iustitiae233/esp32-s3-solder-inspector/archive/auto-generated-schematic/carrier-18pin/README.md

# 载板自动生成草稿（历史参考）

> 本目录不是最终嘉立创 EDA 工程，不用于生成 PCB 或下单。
> 当前有效方案见 `../../../2026-09-06-solder-ai-carrier-pcb.md`。

## 文件

- `carrier-easyeda.json`：按 EasyEDA 标准版公开格式生成的可编辑原理图源文件。
- `carrier-review.pdf`：同源生成的原理图预览，不是 EDA 导出验证结果。
- `connections.csv`：逐脚网络表。
- `../build_carrier.py`：生成脚本。

在嘉立创 EDA **标准版**中通过打开本地 EasyEDA 文件的入口加载 JSON。
目前尚未在实际编辑器中验证导入、运行 ERC 或分配 PCB 封装。
不能将此版本直接转 PCB 下单；接口符号具有电气引脚，但封装为空。

## 18 针为什么够用

依据本地 ATK-MC2640 用户手册 V1.1 和 ATK-OV2640 V2.2 原理图：
相机使用 D0-D7、PCLK、HREF、VSYNC、SDA、SCL，共 13 个 GPIO。
模块自带 24MHz 有源晶振，不接主控 XCLK，GPIO15 留空。
RST 经 10k 上拉到 3V3；PWDN 接地；FLASH 经 10k 下拉到地。
屏幕和触摸合计 9 个 GPIO，按键 1 个，总计 23 个。
GPIO48 现在不接外部灯环，保留为 NC；核心板上的板载 RGB 仍由核心板自身电路决定。
核心板第三脚丝印为 `RST`，原理图和测试点均使用 `RST`，不使用 `EN` 命名。

J3 的针号来自原厂 P1，不是根据名称随意排列：

| 奇数针 | 信号 | 偶数针 | 信号 |
|---|---|---|---|
| 1 | GND | 2 | 3V3 |
| 3 | SCL | 4 | VSYNC |
| 5 | SDA | 6 | HREF |
| 7 | D0 | 8 | RST |
| 9 | D2 | 10 | D1 |
| 11 | D4 | 12 | D3 |
| 13 | D6 | 14 | D5 |
| 15 | PCLK | 16 | D7 |
| 17 | PWDN | 18 | FLASH |

## 相对于原设计的更正

- J1 原理图拆成 44 个 `1x1P` 排母符号：左列为 `J1L01` 至 `J1L22`，
  右列为 `J1R01` 至 `J1R22`，各自从天线端往 USB 端编号。
  PCB 中每个封装必须锁定在 2.54mm 网格；两列中心距按核心板实物测量，
  不是普通双排排母的 2.54mm 间距。
- 实体物料仍建议购买两条 `2.54mm 1x40P 可裁剪单排排母`，各裁为 22P。
  不建议购买 44 个独立排母实体，无法保证插板平整和机械强度。
- J3 改为 2x9；不引出 XCLK。
- 删除外部灯环：不再放置 J4、D1、LED_DIN，也不使用 GPIO48。
- 屏模块已有 S8050 背光驱动，不添加原文中备用的载板低边开关。
- 屏用 3.3V 供电时，原厂图要求短接屏模块自身的 J1 稳压器旁路跳线。
  此 J1 不是载板核心板插座。
- 添加 SCCB 的 4.7k 上拉电阻；模块手册明确允许与 3.3V MCU 直接连接。
- 相机 FLASH 下拉不等于任何跳线状态都能关闭闪光灯。
  核对模块 R2/R3 选择，固件关闭传感器 STROBE；勿同时装通两个选择电阻。

## 上电与出板前必须核查

1. 按实物确认核心板版本、插座间距、针一方向和相机线缆是否镜像。
2. 外部照明改为独立的 USB/DC/插座光源，禁止将 220V 市电引入载板。
3. YD 核心板的 5Vin 引出与 USB 供电存在跳线/二极管路径，确认 IN-OUT 配置与电流能力；
   不要仅凭网络名认定 USB 接入后载板一定有 5V。
4. 核对核心板 LDO 对屏幕、相机与 ESP32 峰值电流的承载及温升。
5. 固件要适配相机自带 24MHz 时钟，不得继续在 GPIO15 输出并外接到模块晶振输出。
   具体摄像头驱动是否支持无外部 XCLK 的初始化路径尚未验证。
6. 分配全部直插封装；6x6 四脚按键需按实际内部共接关系选符号与封装。
7. EDA 导入后导出网表，与 connections.csv 逐脚核对，运行 ERC，再进行 PCB 布局和 DRC。

## 去耦电容的实际位置

- `C2`：紧贴 J2 显示屏接口的 `3V3` 和 `GND` 引脚。
- `C3`：紧贴 J3 相机接口的 `3V3` 和 `GND` 引脚。
- `C4`：紧贴 J1 核心板插座附近的 `3V3` 和 `GND` 引脚，作为载板 3V3 入口去耦。
- `C5`：靠近 `R4/R5` 相机 SCCB 上拉电阻和 J3，接 `3V3` 与 `GND`。

`C1` 不是电源去耦，而是 GPIO14 按键的硬件消抖电容，应靠近 `K1` 和 `J1L20`（GPIO14）放置。
去耦电容应先走短线连接到电源和地，再接接口信号；不要把电容放在接口远处仅通过长线连接。
