iustitiae233/esp32-s3-solder-inspector/docs/reference-renders/camera-dim2.png

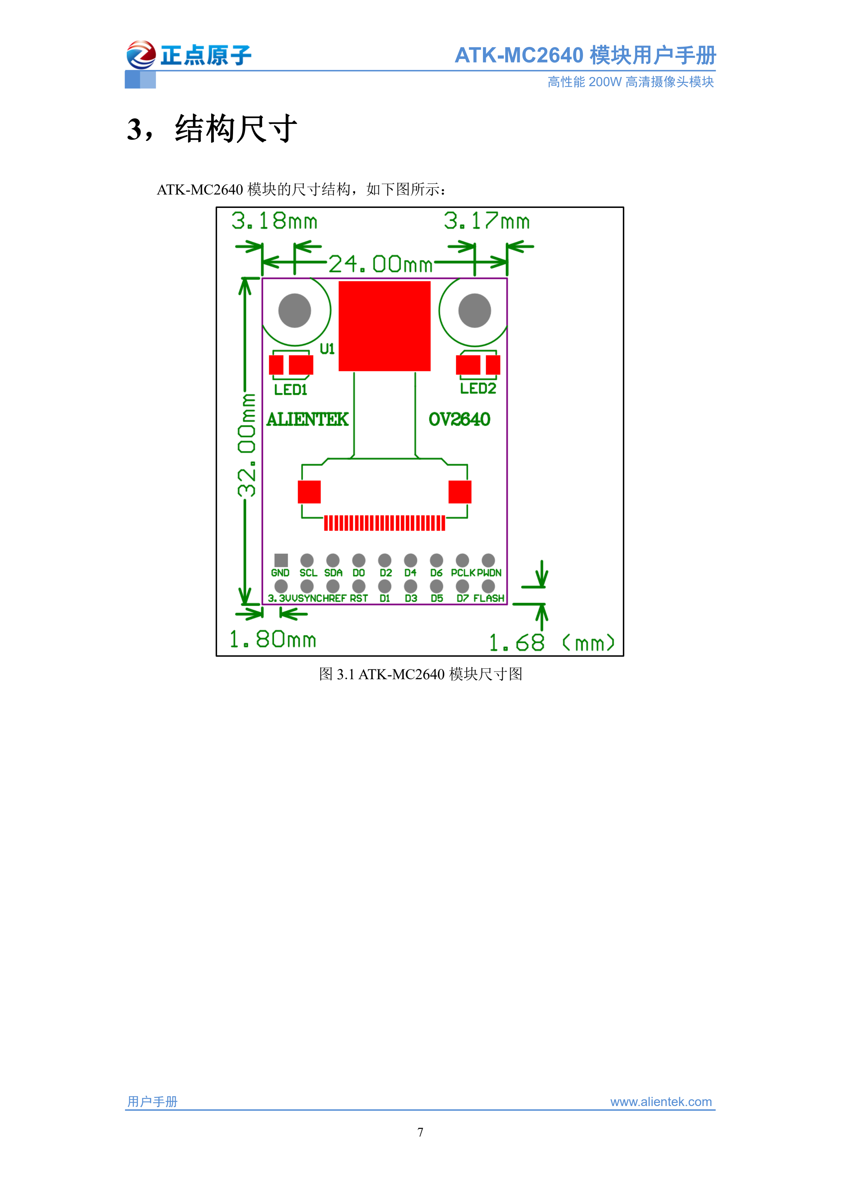
docs/reference-renders/camera-dim2.png
