iustitiae233/esp32-s3-solder-inspector/docs/reference-renders/camera-source.png

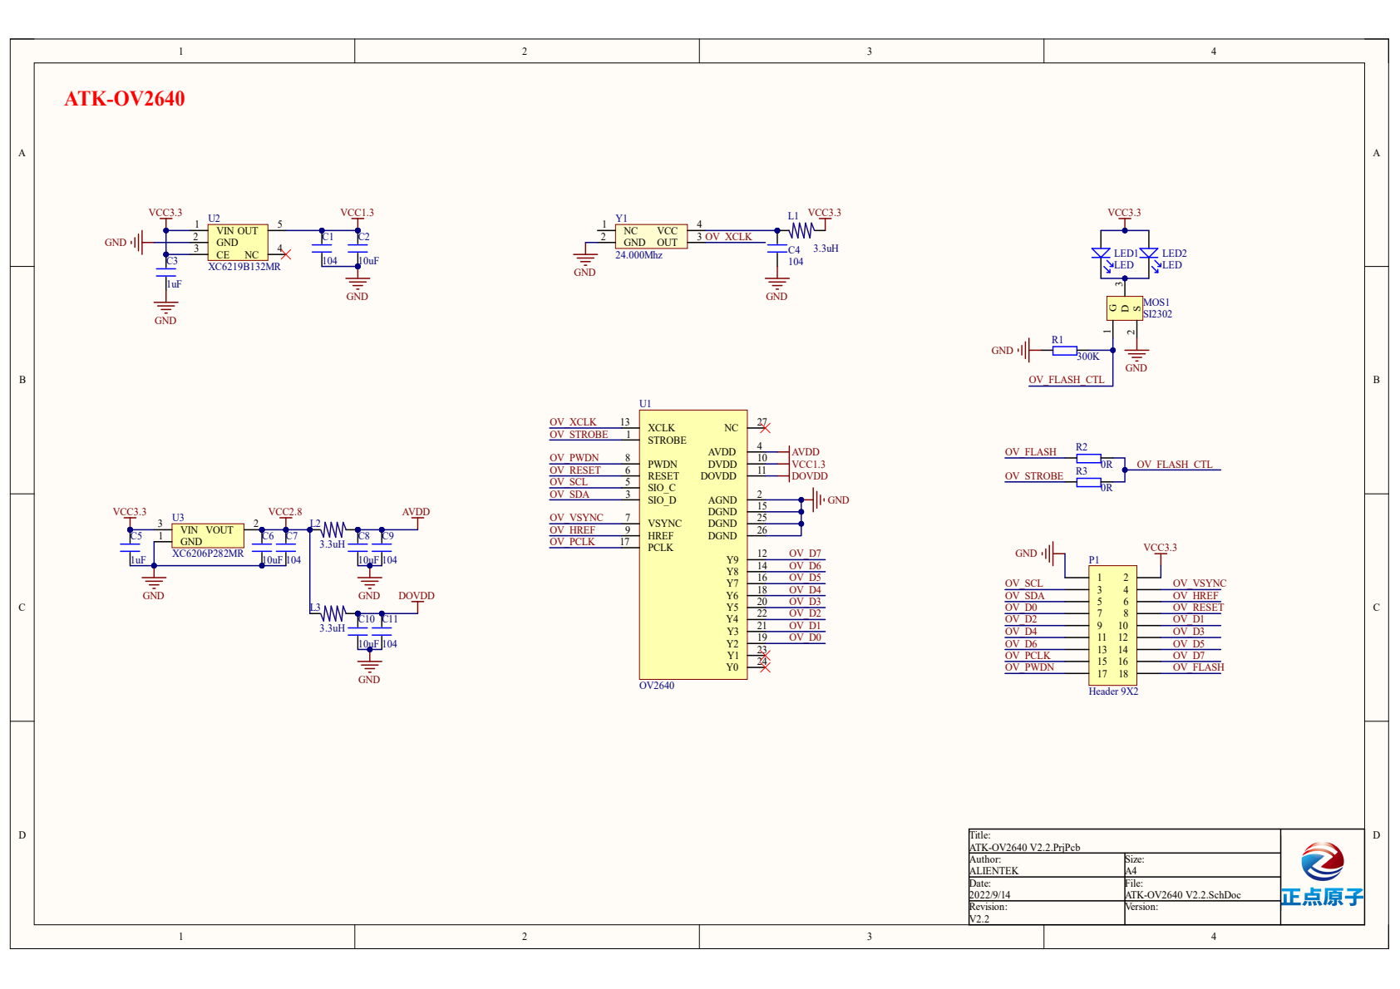
docs/reference-renders/camera-source.png
