iustitiae233/esp32-s3-solder-inspector/docs/reference-renders/core-metric.png

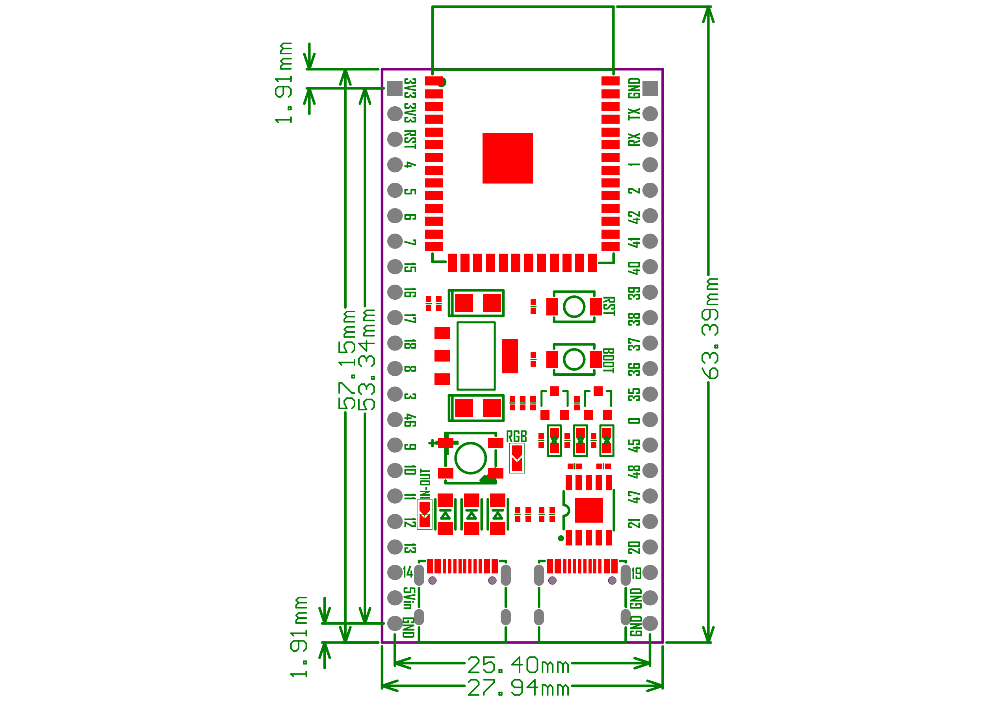
docs/reference-renders/core-metric.png
