iustitiae233/esp32-s3-solder-inspector/docs/reference-renders/pm254-datasheet.png

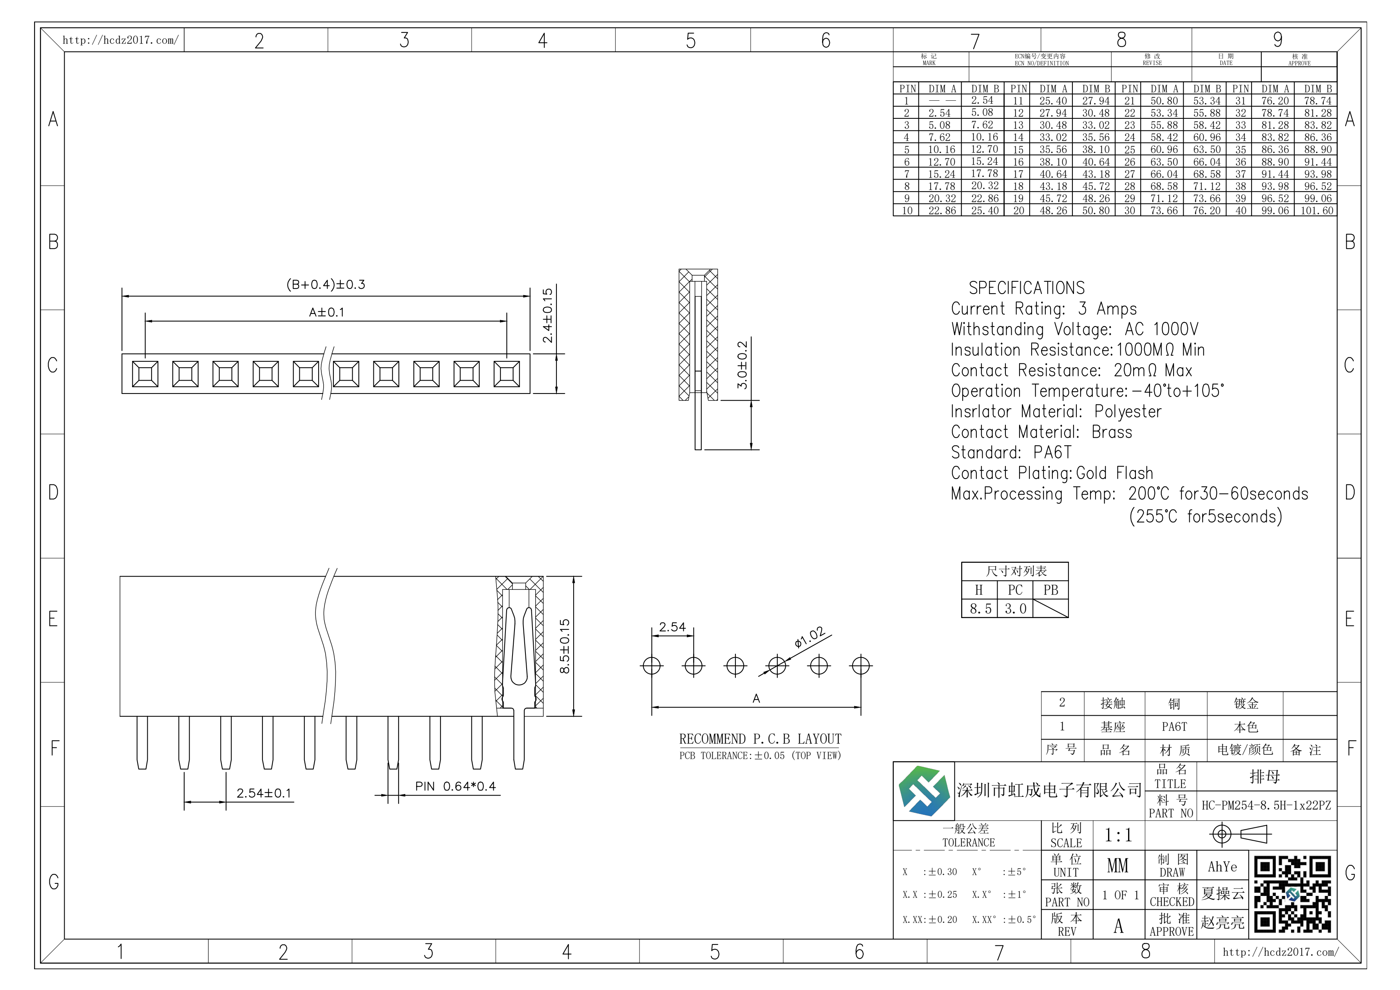
docs/reference-renders/pm254-datasheet.png
