iustitiae233/esp32-s3-solder-inspector/docs/reference-renders/screen-size-1.png

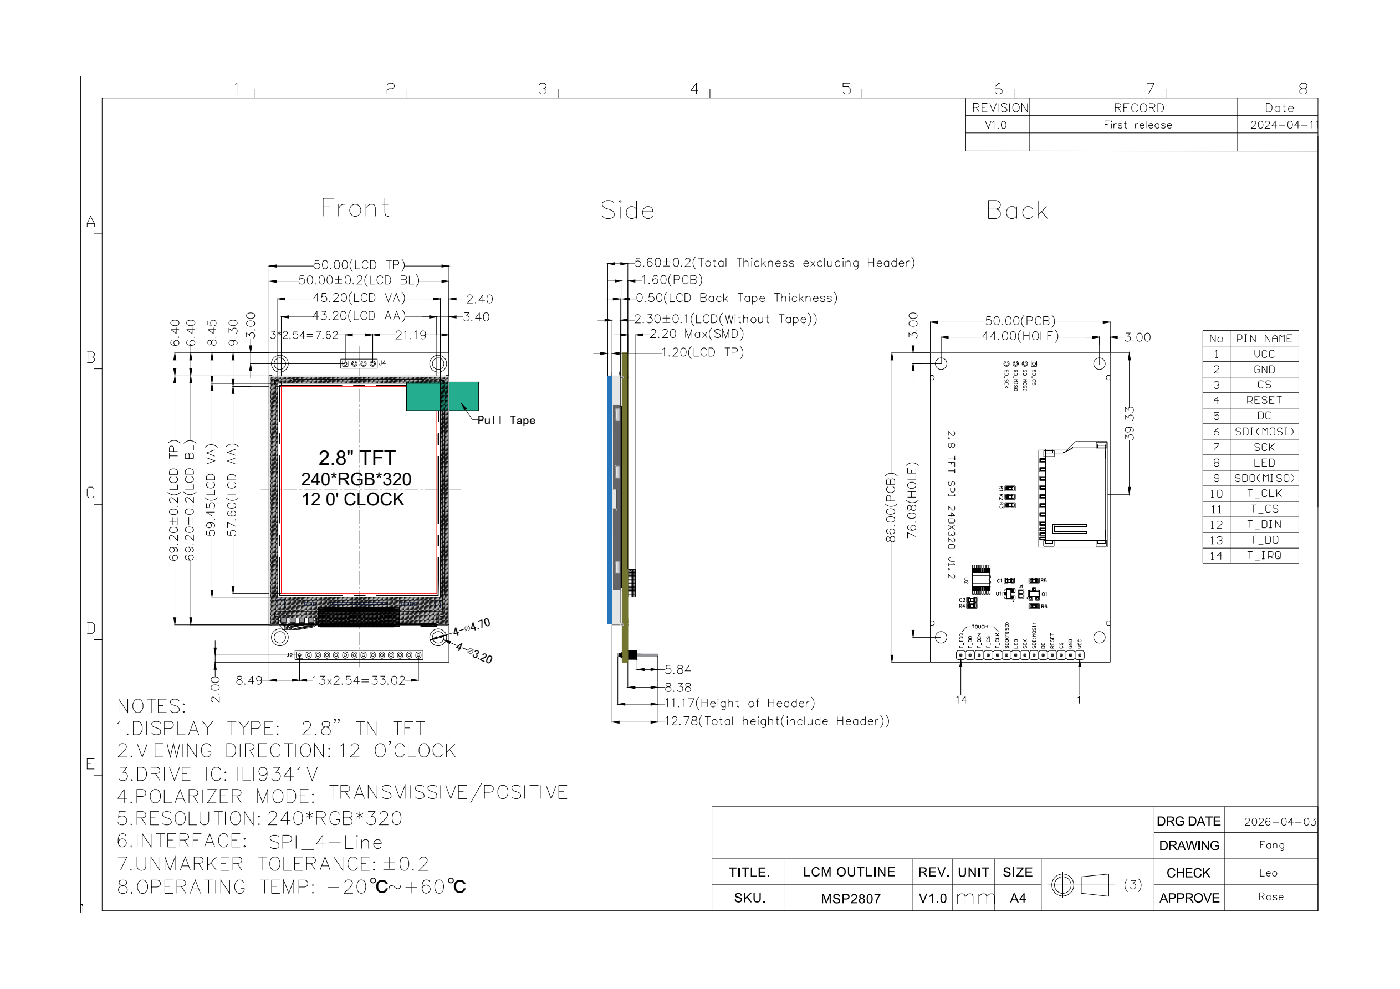
docs/reference-renders/screen-size-1.png
