iustitiae233/esp32-s3-solder-inspector/引脚图（已完善）.PNG

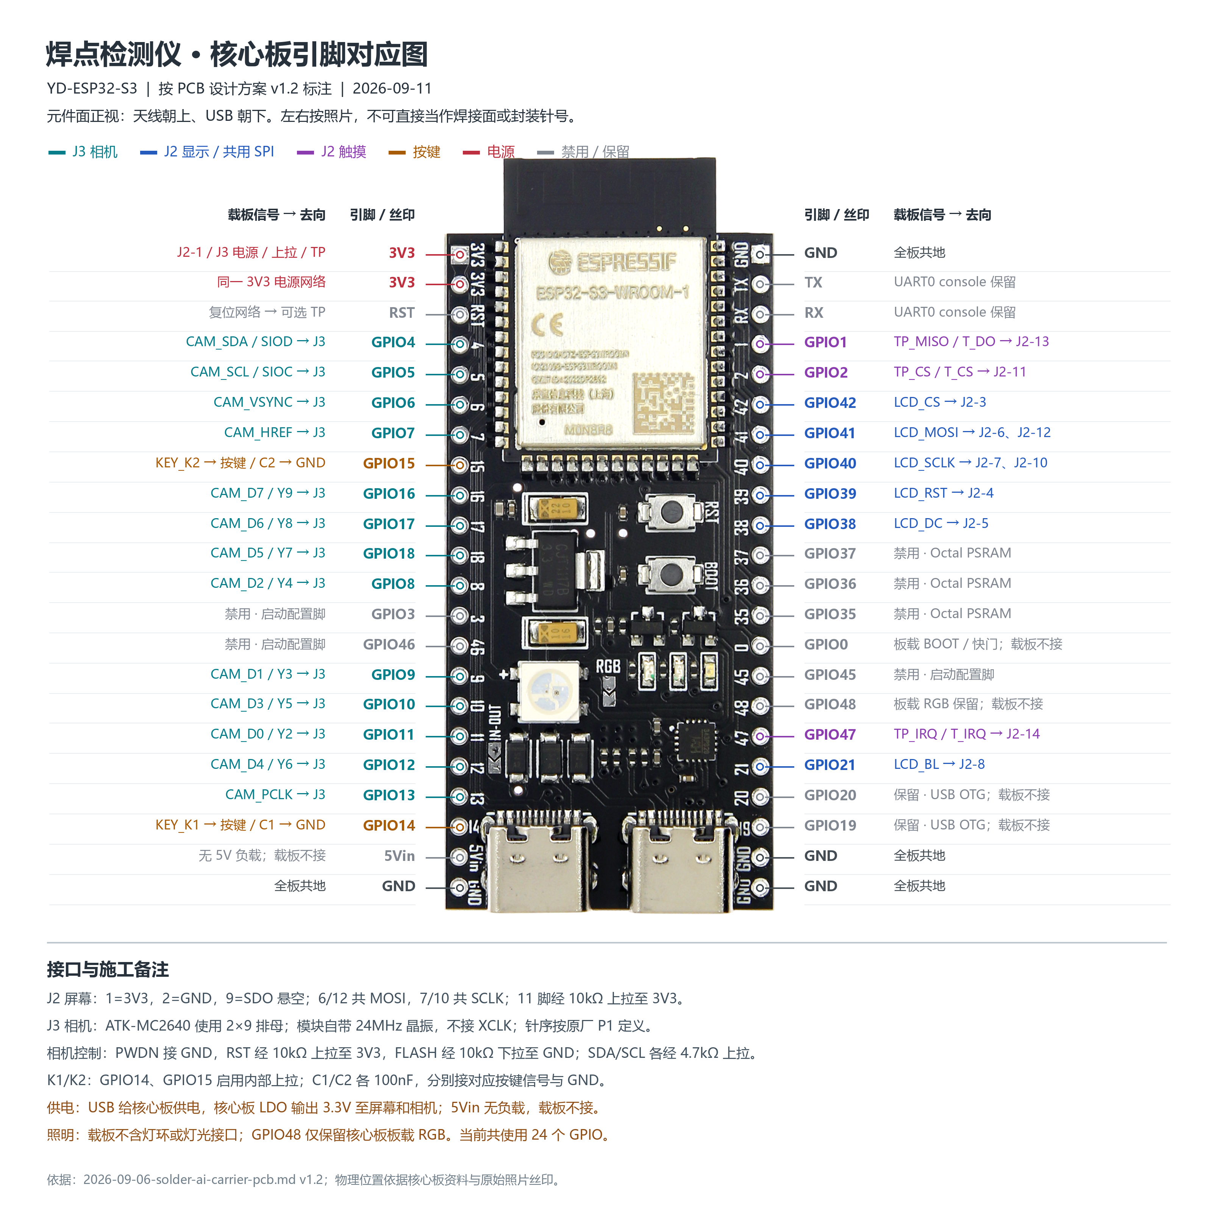
引脚图（已完善）.PNG
