iustitiae233/esp32-s3-solder-inspector/2026-09-06-solder-ai-carrier-pcb.md

# 焊点检测仪载板设计文档

> 状态：原理图及 PCB 已完成，本文按当前设计整理。
> 工具：嘉立创 EDA 标准版。
> 版本：v1.2（2026-09-11）。

---

## 1. 方案概述

本项目使用 YD-ESP32-S3-N16R8 开发板作为可插拔核心板，载板负责连接：

- MSP2807 2.8 英寸 ILI9341 SPI 电阻触摸屏；
- ATK-MC2640（OV2640 V2.2）18 针摄像头模块；
- 两个直插轻触按键；
- 必要的上拉、下拉和去耦器件。

外部照明使用独立 USB、直流或插座光源，不接入载板。载板不包含灯环接口、WS2812、
1N4007 或光源供电电路，也不将 220V 市电引入 PCB。

## 2. 硬件边界

| 项目 | 当前方案 |
|---|---|
| 核心板 | YD-ESP32-S3-N16R8 开发板整板插装 |
| 核心板接口 | 两条 1x22P、2.54mm 直插排母 |
| 屏幕 | MSP2807，ILI9341，240x320，SPI，XPT2046 电阻触摸 |
| 摄像头 | ATK-MC2640 / ATK-OV2640 V2.2，2x9P、2.54mm，共 18 针 |
| 操作输入 | 触摸屏 + K1/K2 两个按键 |
| 照明 | 独立外部光源，与载板电气隔离 |
| 供电 | USB 给核心板供电；核心板板载 LDO 向载板输出 3.3V |
| PCB | 双层板，通孔器件为主，底层优先保持连续 GND 铺铜 |

载板不重复设计 USB、3.3V LDO、BOOT 或复位外围。核心板丝印 `RST` 对应芯片使能/复位
网络，本文统一命名为 `RST`，不再使用 `EN`。

## 3. 核心板器件与机械接口

原理图使用嘉立创 EDA 中与实物匹配的 YD-ESP32-S3-N16R8 44 引脚开发板器件，
不再把左右两排画成两个独立连接器。PCB 封装必须满足：

- 左右各 22 个通孔；
- 同排孔距 2.54mm；
- 两排孔中心距 25.40mm；
- 每排首尾孔中心距 53.34mm；
- 开发板外形约 63.39mm x 27.94mm；
- USB、天线端和 1 脚方向与实物一致；
- 原理图引脚编号与 PCB 焊盘编号一一对应。

实际装配使用两条 `HC-PM254-8.5H-1x22PZ` 排母。其主要参数为 1x22P、2.54mm 间距、
胶体高度 8.5mm、推荐钻孔约 1.02mm。焊接时将开发板插入两条排母后再焊排母，作为定位治具。

### 3.1 GPIO 分配

| 功能 | GPIO | 功能 | GPIO |
|---|---:|---|---:|
| CAM_D0 | 11 | LCD_SCLK / T_CLK | 40 |
| CAM_D1 | 9 | LCD_MOSI / T_DIN | 41 |
| CAM_D2 | 8 | LCD_CS | 42 |
| CAM_D3 | 10 | LCD_DC | 38 |
| CAM_D4 | 12 | LCD_RST | 39 |
| CAM_D5 | 18 | LCD_BL | 21 |
| CAM_D6 | 17 | TP_MISO / T_DO | 1 |
| CAM_D7 | 16 | TP_CS / T_CS | 2 |
| CAM_VSYNC | 6 | TP_IRQ / T_IRQ | 47 |
| CAM_HREF | 7 | KEY_K1 | 14 |
| CAM_PCLK | 13 | CAM_SDA | 4 |
| CAM_SCL | 5 | KEY_K2 | 15 |

共使用 24 个 GPIO。相机自带 24MHz 晶振，因此原 XCLK 使用的 `GPIO15` 改接第二个按键
K2；`GPIO48` 不再连接外部灯，但核心板自身的板载 RGB 可能仍占用它。

以下引脚不用于载板扩展：

- GPIO19、GPIO20：USB；
- GPIO35、GPIO36、GPIO37：N16R8 模组内部 Octal PSRAM；
- GPIO0、GPIO3、GPIO45、GPIO46：启动配置相关；
- TX、RX：UART0 下载和调试；
- GPIO48：保留给核心板板载 RGB；
- 其他未使用引脚在原理图中放置 NC 标识。

## 4. J2 显示屏接口

接口为 `HDR-F_2.54_1x14P` 直插排母。针脚定义：

| 针号 | 模块丝印 | 载板网络 | GPIO | 说明 |
|---:|---|---|---:|---|
| 1 | VCC | 3.3V | - | 由核心板 LDO 输出供电 |
| 2 | GND | GND | - |  |
| 3 | CS | LCD_CS | 42 |  |
| 4 | RESET | LCD_RST | 39 |  |
| 5 | DC | LCD_DC | 38 |  |
| 6 | SDI/MOSI | LCD_MOSI | 41 | 与 T_DIN 共网 |
| 7 | SCK | LCD_SCLK | 40 | 与 T_CLK 共网 |
| 8 | LED | LCD_BL | 21 | 模块板载 S8050 驱动背光 |
| 9 | SDO/MISO | NC | - | 当前只写屏幕，不读取屏幕数据 |
| 10 | T_CLK | LCD_SCLK | 40 | 触摸 SPI 时钟 |
| 11 | T_CS | TP_CS | 2 | R1 10k 上拉到 3.3V |
| 12 | T_DIN | LCD_MOSI | 41 | 触摸 SPI 输入 |
| 13 | T_DO | TP_MISO | 1 | 触摸 SPI 输出 |
| 14 | T_IRQ | TP_IRQ | 47 | 触摸中断 |

网络名必须统一使用 `LCD_SCLK`，不得写成 `LCD_SLCK`。屏幕模块使用 3.3V 供电时，
按 MSP2807 原理图确认模块自身的稳压旁路跳线状态。

## 5. J3 摄像头接口

ATK-MC2640 模块自带 24MHz 有源晶振和稳压电路，载板不提供 XCLK。接口为 2x9P、
2.54mm 排母，针号严格按原厂 P1 定义：

| 奇数针 | 信号 | 连接 | 偶数针 | 信号 | 连接 |
|---:|---|---|---:|---|---|
| 1 | GND | GND | 2 | 3.3V | 3.3V |
| 3 | SCL | GPIO5 | 4 | VSYNC | GPIO6 |
| 5 | SDA | GPIO4 | 6 | HREF | GPIO7 |
| 7 | D0 | GPIO11 | 8 | RST | R2 10k 上拉至 3.3V |
| 9 | D2 | GPIO8 | 10 | D1 | GPIO9 |
| 11 | D4 | GPIO12 | 12 | D3 | GPIO10 |
| 13 | D6 | GPIO17 | 14 | D5 | GPIO18 |
| 15 | PCLK | GPIO13 | 16 | D7 | GPIO16 |
| 17 | PWDN | GND | 18 | FLASH | R3 10k 下拉至 GND |

R4、R5 分别将 CAM_SDA、CAM_SCL 通过 4.7k 上拉到 3.3V。相机模块的 FLASH 还受模块
内部 R2/R3 选择电阻和传感器 STROBE 控制，使用时确认模块焊接状态并在固件中关闭闪光。

## 6. 按键

K1/SW1、K2/SW2 均为 6x6x5mm 直插常开轻触开关：

```text
GPIO14 / KEY_K1 ----+---- K1 ---- GND
                    |
                    +---- C1 100nF ---- GND

GPIO15 / KEY_K2 ----+---- K2 ---- GND
                    |
                    +---- C2 100nF ---- GND
```

GPIO14、GPIO15 均在固件中启用内部上拉，按下时读取低电平。C1、C2 分别为 K1、K2
提供硬件消抖，不属于电源去耦，应分别靠近对应按键和 GPIO 连接处放置。固件仍建议
保留 20-50ms 消抖，以提高长按和连按识别的稳定性。

## 7. 电源与去耦

USB 向开发板输入 5V，开发板板载 LDO 产生 3.3V，再通过开发板 3.3V 引脚向屏幕、相机和
上拉电阻供电。载板上的 `3.3V` 电源符号表示同一个网络，本身不会产生电压。

外接灯已删除，因此载板没有 5V 负载。核心板 `5Vin` 若未使用，应标为 NC；不要仅放置一个
孤立 `+5V` 电源符号。也不要同时从外部 5V 和核心板 USB 反向给同一网络供电。

当前电容配置：

| 位号 | 数值 | 用途 | PCB 放置位置 |
|---|---|---|---|
| C1 | 100nF | 按键硬件消抖 | 紧贴 K1 和 GPIO14 网络 |
| C2 | 100nF | 按键硬件消抖 | 紧贴 K2 和 GPIO15 网络 |
| C3 | 100nF | 核心板 3.3V 入口去耦 | 紧贴核心板 3.3V/GND 引脚 |
| C4 | 100nF | 显示屏接口去耦 | 紧贴 J2 的 VCC/GND 引脚 |
| C5 | 100nF | 摄像头接口去耦 | 紧贴 J3 的 3.3V/GND 引脚 |

C1、C2 接在对应按键信号与 GND 之间；它们不是 3.3V 去耦电容。C3-C5 才是电源去耦，
均并联在 `3.3V-GND` 之间，不能串联在供电路径上。上拉电阻本身不需要额外去耦。

## 8. 辅助器件

| 位号 | 参数 | 用途 |
|---|---|---|
| R1 | 10k，直插 | TP_CS 上拉至 3.3V |
| R2 | 10k，直插 | CAM_RST 上拉至 3.3V |
| R3 | 10k，直插 | CAM_FLASH 下拉至 GND |
| R4 | 4.7k，直插 | CAM_SDA 上拉至 3.3V |
| R5 | 4.7k，直插 | CAM_SCL 上拉至 3.3V |
| C1 | 100nF，直插 | 按键消抖 |
| C2 | 100nF，直插 | K2 按键消抖 |
| C3-C5 | 100nF，直插 | 3.3V 去耦 |

## 9. PCB 布局与走线

模块机械尺寸：

- YD-ESP32-S3 开发板约 63.39mm x 27.94mm；
- MSP2807 屏幕 PCB 为 50mm x 86mm；
- ATK-MC2640 摄像头模块为 24mm x 32mm；
- 最终板框、安装孔和器件坐标以已完成的嘉立创 EDA PCB 工程为准。

走线要求：

1. CAM_D0-D7、PCLK、HREF、VSYNC 优先短、直、少过孔，PCLK 尤其避免绕行；
2. 相机并行数据线不要求严格等长，但长度应大致接近并保持连续参考地；
3. LCD_SCLK、LCD_MOSI 和片选线尽量短；
4. 3.3V 主干建议至少 20mil；普通信号可用 8-10mil；
5. 底层优先铺连续 GND 铜，避免高速信号跨越地平面裂缝；
6. C3、C4、C5 必须在 PCB 实际布局中贴近各自接口电源脚，原理图上的距离没有意义；
7. 核心板 USB 口、BOOT/RST 按键和天线区域不得被屏幕、外壳或高器件遮挡；
8. 丝印标注连接器 1 脚、模块朝向和主要信号，防止相机或屏幕反插。

## 10. 最终 BOM

| 类别 | 型号/规格 | 数量 |
|---|---|---:|
| 核心板 | YD-ESP32-S3-N16R8 | 1 |
| 核心板排母 | HC-PM254-8.5H-1x22PZ，1x22P，2.54mm | 2 |
| 显示屏排母 J2 | HDR-F_2.54_1x14P | 1 |
| 摄像头排母 J3 | 2x9P，2.54mm，直插排母 | 1 |
| 按键 K1/K2（SW1/SW2） | 6x6x5mm，直插，常开 | 2 |
| R1-R3 | 10k，1/4W，直插 | 3 |
| R4-R5 | 4.7k，1/4W，直插 | 2 |
| C1-C5 | 100nF，直插瓷片/独石 | 5 |

不再采购 J4、1N4007、S8050、1k 背光电阻及 WS2812 灯环。

## 11. 制板前检查

- [ ] 原理图 ERC 无错误；未使用引脚已放 NC 标识；
- [ ] 原理图引脚编号与 PCB 封装焊盘编号完全对应；
- [ ] 3.3V 网络名全图一致，没有混用 `3V3`；
- [ ] LCD_SCLK 拼写全图一致；
- [ ] J2-9 SDO 为 NC；GPIO15 仅连接 K2；GPIO48 和禁用/保留 GPIO 未误接；
- [ ] J3 针号及 1 脚方向与 ATK-MC2640 实物一致；
- [ ] 核心板两排孔中心距 25.40mm，开发板方向正确；
- [ ] PCB DRC 无错误，板框闭合，安装孔和边缘间距符合工艺要求；
- [ ] 已检查屏幕、相机、核心板和外壳之间无机械干涉。

## 12. 焊接与验收

1. 先焊电阻、电容和按键；
2. 使用核心板定位两条 1x22 排母后焊接，避免排母倾斜；
3. 焊接 J2/J3 前确认 1 脚和模块朝向；
4. 不插模块时检查 3.3V 对 GND 无短路；
5. 插入核心板并用 USB 供电，测量载板 3.3V；
6. 断电后插屏幕与相机，再逐项测试显示、触摸、按键和摄像头；
7. 外部照明单独供电，调整角度和漫射，避免焊点高光过曝。

验收项目：

- [ ] 3.3V 电压正常且核心板 LDO 无异常发热；
- [ ] 屏幕显示正常，触摸点按与坐标方向正常；
- [ ] K1、K2 按键均可识别，长按和连按无明显误触发；
- [ ] 相机 SCCB 初始化成功，图像无花屏、错位或持续丢帧；
- [ ] 外部光源下焊点曝光稳定、无严重阴影和高光溢出。

## 13. 变更记录

| 日期 | 版本 | 变更 |
|---|---|---|
| 2026-09-06 | v0.1 | 初版：16 针相机、GPIO15 XCLK、GPIO48 灯环方案 |
| 2026-09-07 | v0.2 | 相机改为 ATK-MC2640 18 针，自带 24MHz 晶振；PWDN/RST/FLASH 固定电平 |
| 2026-09-09 | v0.3 | 删除外接灯环、J4、1N4007 和 GPIO48 外接功能；统一 RST 命名 |
| 2026-09-10 | v0.4 | 核心板改用完整 44 引脚器件；修正原理图引脚与封装焊盘编号 |
| 2026-09-11 | v1.0 | 根据已完成原理图和 PCB 整理为当前设计基线 |
| 2026-09-11 | v1.1 | GPIO15 增加第二个按键 K2；GPIO 使用数改为 24；K2 使用固件消抖 |
| 2026-09-11 | v1.2 | 补充 K2 的 C2 100nF 硬件消抖电容；BOM 恢复为 C1-C5 共 5 个 |
