iustitiae233/esp32-s3-solder-inspector/docs/reference-renders/camera-manual-p4.png

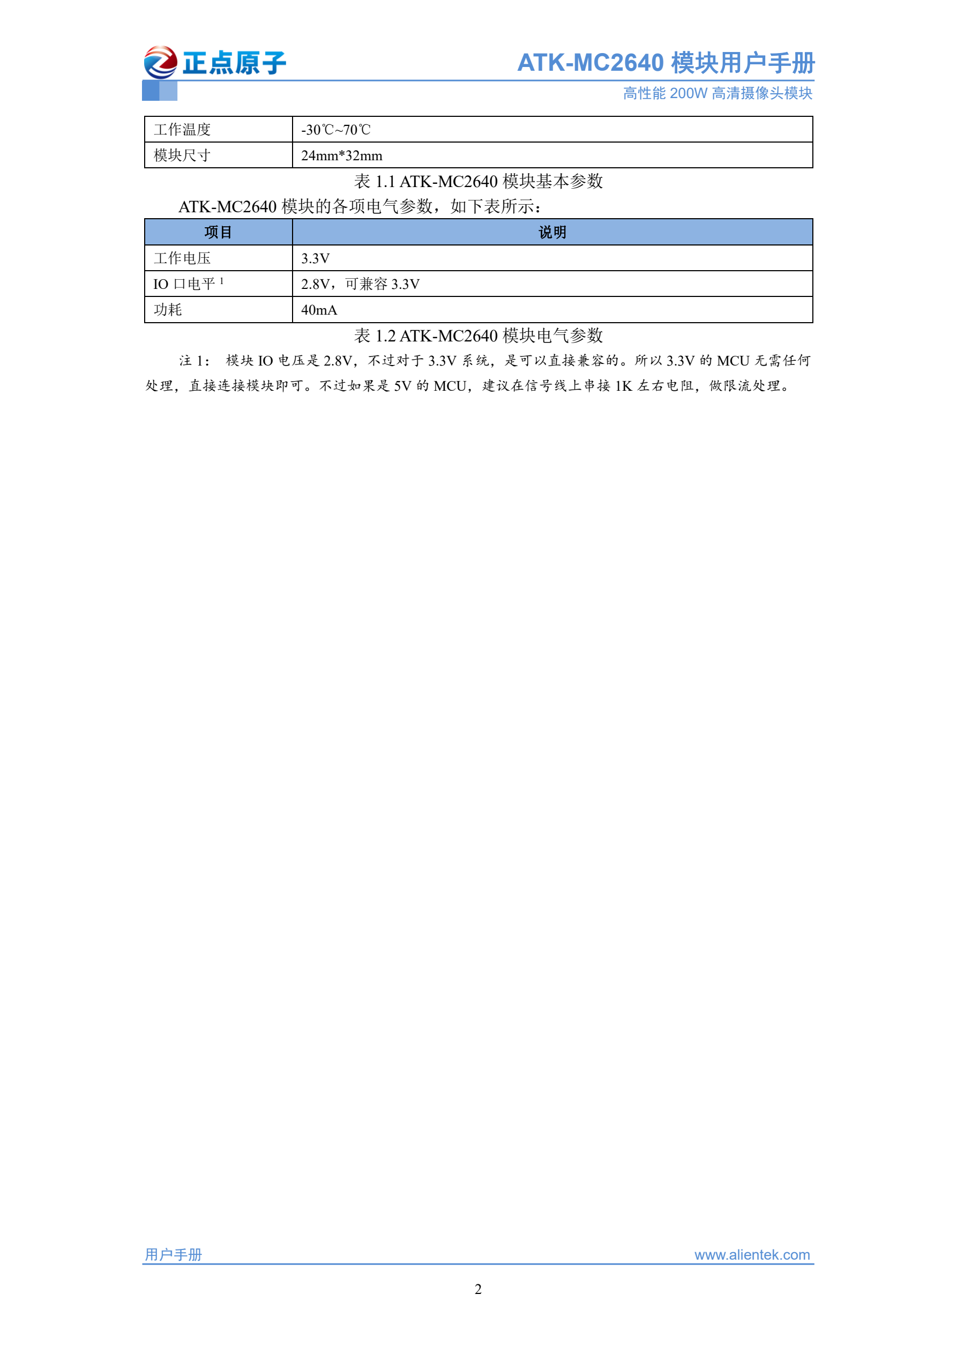
docs/reference-renders/camera-manual-p4.png
