iustitiae233/esp32-s3-solder-inspector/OV2640摄像头模块资料（新版本）/1，原理图/ATK-OV2640 V2.2.pdf

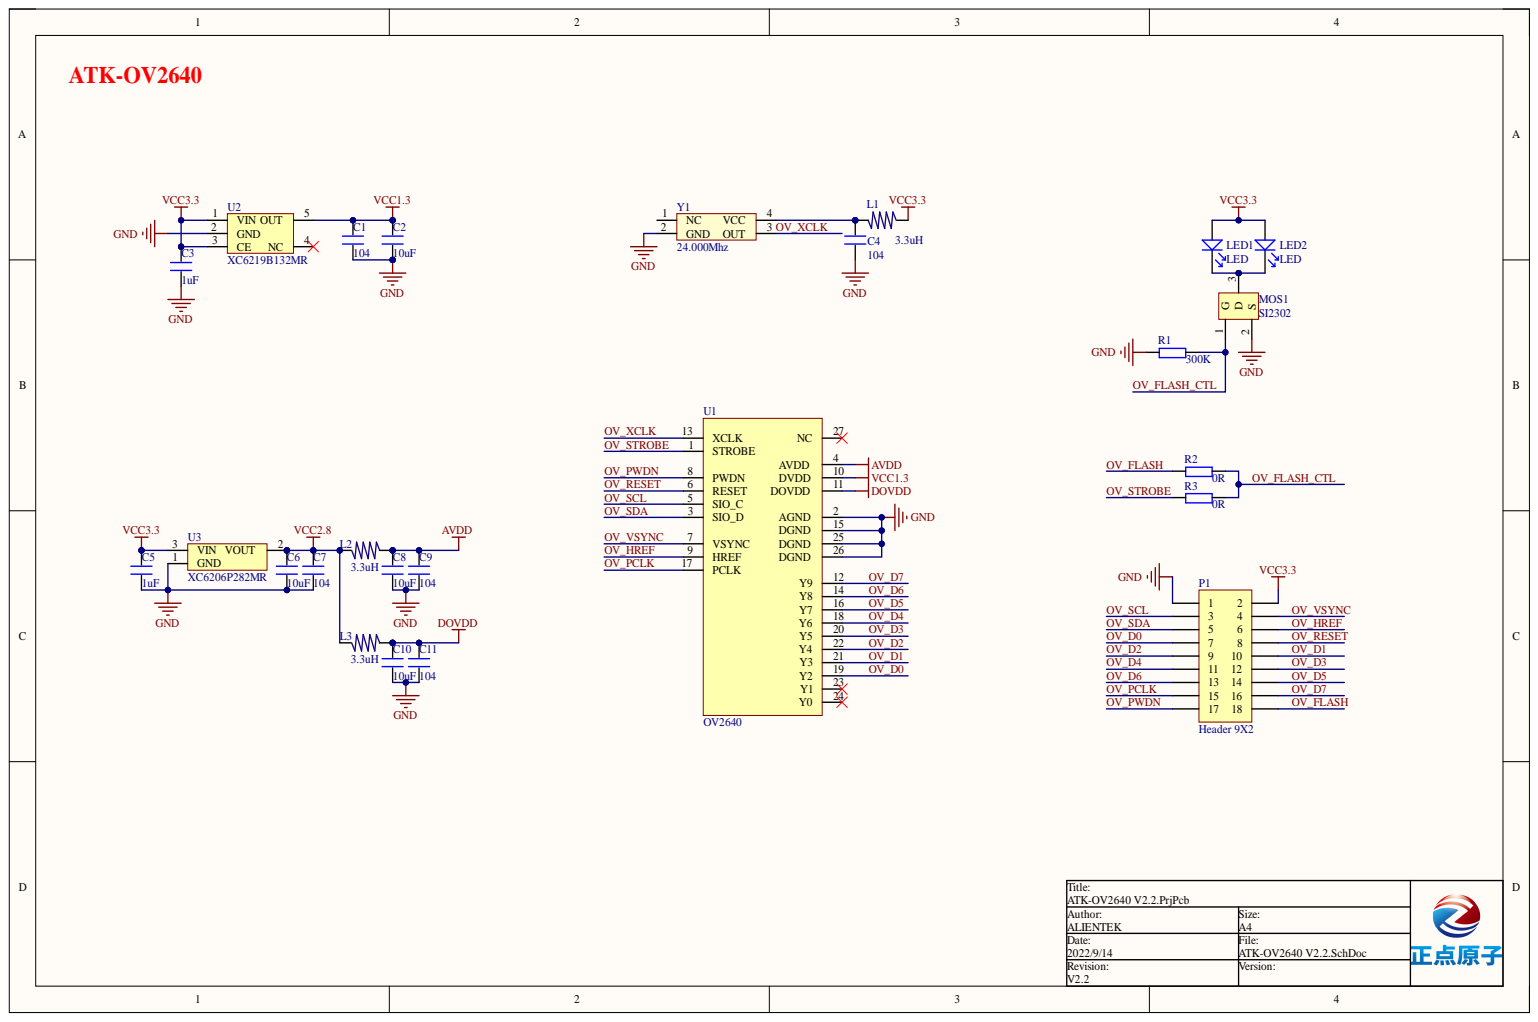
[picture p10: page 1]

Ti t le: AT K-O V 2 6 4 0 V 2.2.PrjPcb

A u t h or: A L IE N T E K | Size: A 4

Date: 2 0 2 2 / 9 / 1 4 | Fi le: AT K-O V 2 6 4 0 V 2.2.Sch D o c

Rev i s i o n : V 2.2 | Vers i o n :

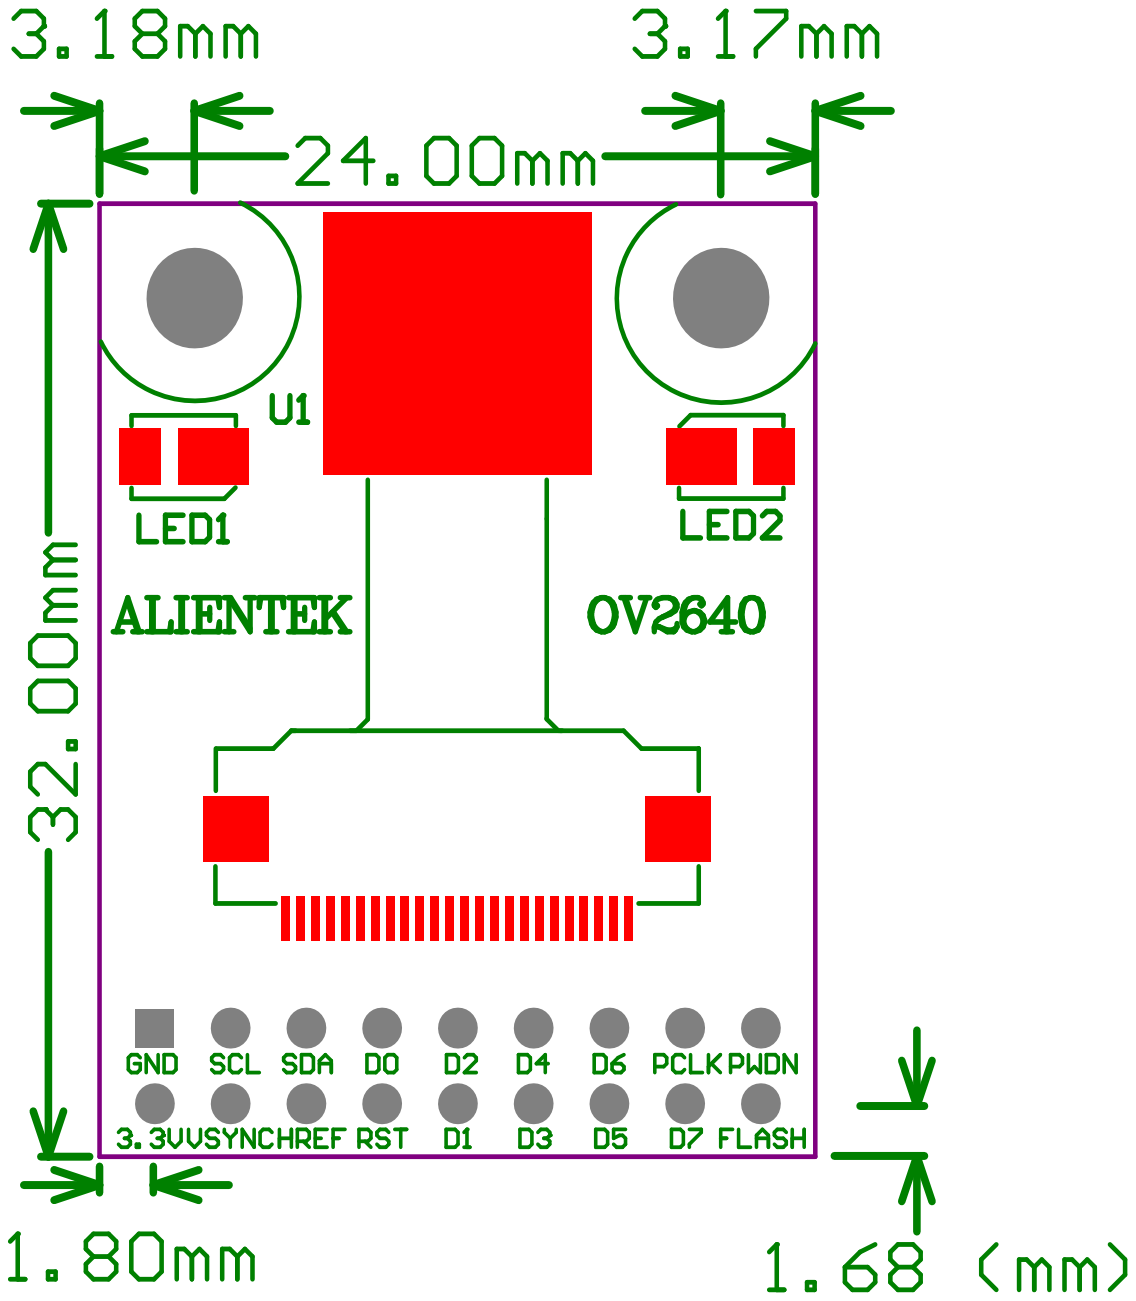
[picture p11: page 2]
