iustitiae233/esp32-s3-solder-inspector/archive/auto-generated-schematic/carrier-18pin/carrier-review.pdf

# 焊点检测仪载板 / YD-ESP32-S3 + ATK-OV2640 V2.2

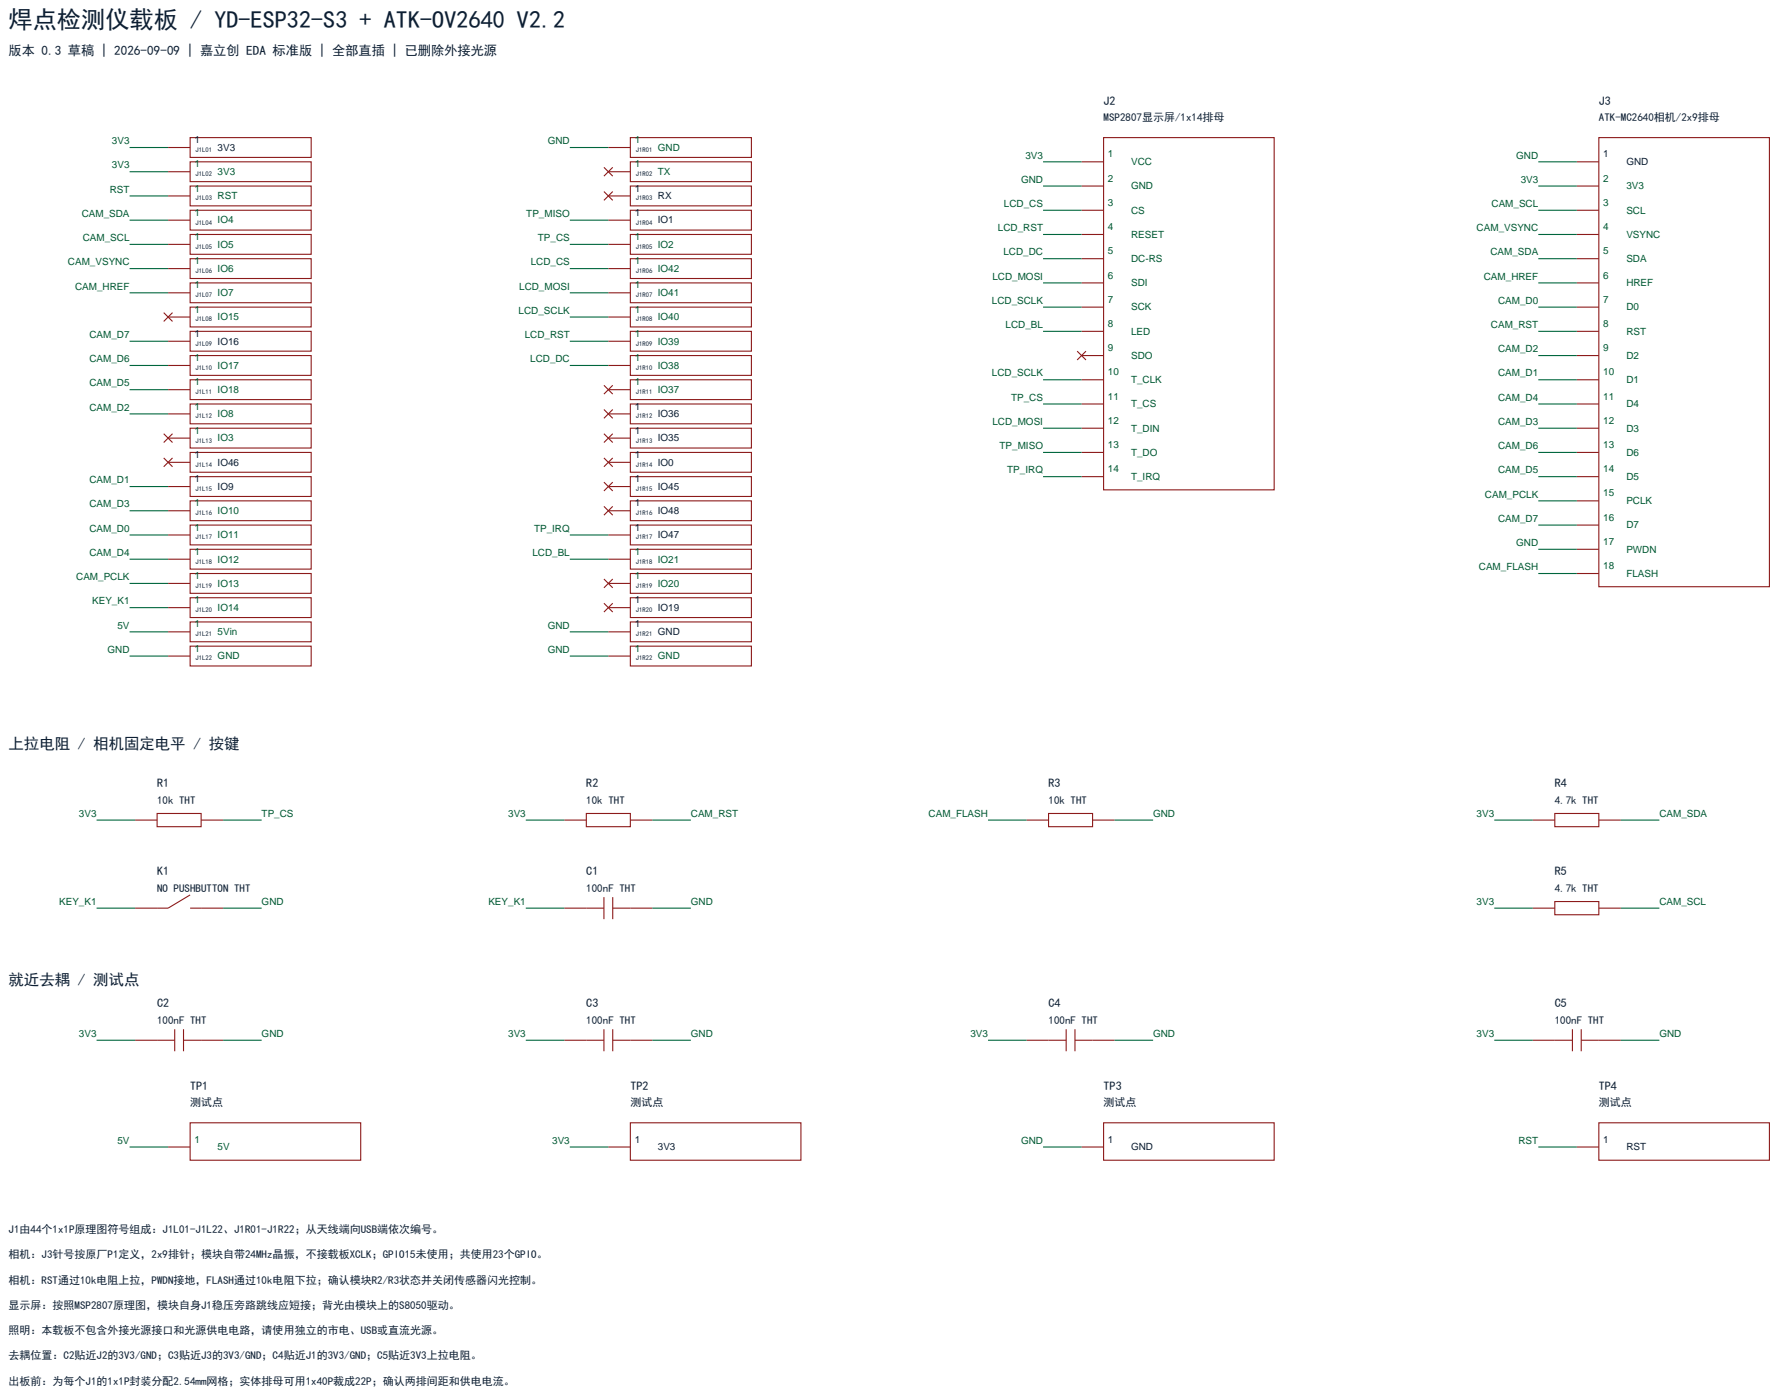
[picture p12: page 1]

版本 0.3 草稿 | 2026-09-09 | 嘉立创 EDA 标准版 | 全部直插 | 已删除外接光源

照明：本载板不包含外接光源接口和光源供电电路，请使用独立的市电、USB或直流光源。

去耦位置：C2贴近J2的3V3/GND；C3贴近J3的3V3/GND；C4贴近J1的3V3/GND；C5贴近3V3上拉电阻。
