iustitiae233/esp32-s3-solder-inspector/(list of files, drawings)

Other design files:
archive/auto-generated-schematic/carrier-18pin/carrier-easyeda.json
