iustitiae233/esp32-s3-solder-inspector/OV2640摄像头模块资料（新版本）/2，程序源码/ATK-MC2640模块测试实验（GPIO）/精英STM32F103开发板/精英STM32F103开发板/User/main.c

/**
 ****************************************************************************************************
 * @file        main.c
 * @author      正点原子团队(ALIENTEK)
 * @version     V1.0
 * @date        2022-06-21
 * @brief       ATK-MC2640模块测试实验（GPIO）
 * @license     Copyright (c) 2020-2032, 广州市星翼电子科技有限公司
 ****************************************************************************************************
 * @attention
 *
 * 实验平台:正点原子 STM32F103开发板
 * 在线视频:www.yuanzige.com
 * 技术论坛:www.openedv.com
 * 公司网址:www.alientek.com
 * 购买地址:openedv.taobao.com
 *
 ****************************************************************************************************
 */

#include "./SYSTEM/sys/sys.h"
#include "./SYSTEM/delay/delay.h"
#include "./SYSTEM/usart/usart.h"
#include "./BSP/LED/led.h"
#include "./BSP/KEY/key.h"
#include "./BSP/LCD/lcd.h"
#include "demo.h"

/**
 * @brief       显示实验信息
 * @param       无
 * @retval      无
 */
void show_mesg(void)
{
    /* LCD显示实验信息 */
    lcd_show_string(10, 10, 220, 32, 32, "STM32", RED);
    lcd_show_string(10, 47, 220, 24, 24, "ATK-MC2640", RED);
    lcd_show_string(10, 76, 220, 16, 16, "ATOM@ALIENTEK", RED);
    
    /* 串口输出实验信息 */
    printf("\n");
    printf("********************************\r\n");
    printf("STM32\r\n");
    printf("ATK-MC2640\r\n");
    printf("ATOM@ALIENTEK\r\n");
    printf("********************************\r\n");
    printf("\r\n");
}

int main(void)
{
    HAL_Init();                         /* 初始化HAL库 */
    sys_stm32_clock_init(RCC_PLL_MUL9); /* 设置时钟, 72Mhz */
    delay_init(72);                     /* 延时初始化 */
    usart_init(115200);                 /* 串口初始化为115200 */
    led_init();                         /* 初始化LED */
    key_init();                         /* 初始化按键 */
    lcd_init();                         /* 初始化LCD */
    show_mesg();                        /* 显示实验信息 */
    demo_run();                         /* 运行示例程序 */
}
