iustitiae233/esp32-s3-solder-inspector/(commit log)

2026-09-11 基线:载板设计文档 v1.2 与硬件资料(YD-ESP32-S3/MSP2807/ATK-MC2640)
    [carrier-easyeda.json, connections.csv]
2026-09-11 spec:焊点缺陷检测仪软件系统设计(架构/固件/UI/边缘AI/协议/PC端/工具链)
2026-09-11 skill:引入 ESP32 嵌入式开发 skill(ESP-IDF/S3 规格/LVGL v8-v9.5 参考/引脚校验,源 ezrover/ESP32-AI-Agent-Skill,MIT)
2026-09-11 plan:软件系统实施计划(11任务/接口契约/难点代码/验证步骤)
2026-09-11 feat(fw): ILI9341+LVGL9显示移植/SPI共享总线/XPT2046触摸/背光PWM/NVS配置存储
    [partitions.csv]
2026-09-11 feat(fw): OV2640相机(xclk=-1自带晶振)+帧分发器+K1/K2按键任务
2026-09-11 feat(fw): TFLM边缘推理(FATFS模型加载/RGB565缩放int8量化/softmax)
2026-09-11 feat(fw): WiFi STA + PC链路TCP客户端(流式协议解析/心跳/3s自动重连/retarget热重连)
2026-09-11 feat(fw): LVGL中文UI五页面+触摸校准+main粘合,固件功能完备
2026-09-11 feat(pc): 协议库+PySide6检测台(TCP server/YOLOv8推理/采集归档),修正DETECT框长20→22字节(固件同步)
2026-09-11 feat(tools): 训练与烧录工具链(边缘int8全量化+YOLOv8+FATFS打包烧录;中文路径imdecode修复;representative锁定[-1,1]满量程)
2026-09-11 docs: README 软件全流程(编译/PC端/数据到模型闭环/协议/排障)+ LabelImg 标注指南
2026-09-11 fix(fw): 验证阶段修复——TFLM resolver 补 ADD/MEAN/PAD(对账实际导出模型)、WiFi 重试防 esp_wifi_start 重入 abort、LVGL %f 支持开关、窄区 flush 全宽 stride
    [bsp_display.c]
