iustitiae233/esp32-s3-solder-inspector/(notices)

Notices in the files:
OV2640摄像头模块资料（新版本）/2，程序源码/ATK-MC2640模块测试实验（GPIO）/精英STM32F103开发板/精英STM32F103开发板/User/demo.c:
@license Copyright (c) 2020-2032, ¹ãÖÝÊÐÐÇÒíµç×Ó¿Æ¼¼ÓÐÏÞ¹«Ë¾
